angelyanga/BatLog/Study_Media/Setup_of_System.jpg

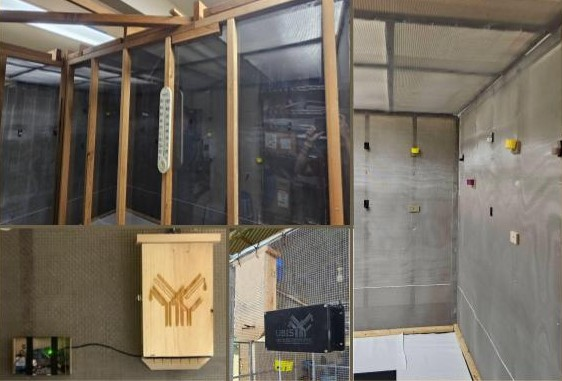
Study_Media/Setup_of_System.jpg
