angelyanga/BatLog/README.md

# BatLog
The BatLog repository stores the Instruction Manual, code, 3D-printing, and other resources for the BatLog system.
