angelyanga/BatLog/Supplemental_Materials/BatLog Bill of Materials.xlsx

Sheet: BatLog v0.2 - Teensy 4.1 Double
Subsystem | Vendor | Name | Product # | Link | Pack of | Qty Needed | Unit Cost | Notes
Main Products
Microcontroller | Amazon | Teensy 4.1 (RTC + microSD) | B088JY7P2H | https://a.co/d/0er9vC9 | 1 | 1 | *see link for updated prices
RFID Reader | Amazon | LICHIFIT 134.2K AGV RFID Module FDXB Animal Ear Tag Reader TTL FDX-B ISO11784/85 Long Distance Card Reader Module | B0B8NXKPZB | https://a.co/d/czAAwGe | 1 | 2 |  | Comes with a square antenna that was meld into a rectangle for BatLog
RFID Antenna | Amazon | 24 AWG Copper Wire | B01NBM0MB5 | https://a.co/d/cEZuwrY | 1 | 1 |  | Used for hand-coiled BatLog antennas
RTC | Amazon | DS3231 Real Time Clock Module High Precision AT24C32 IIC RTC Sensor for Arduino Nano Mega2560 Leonardo Raspberry Pi (Pack of 5) | B0CPF8X8NW | https://a.co/d/8d5YQoa | 5 | 1
RTC | Amazon | CR2032 Coin Batteries | B0CH1N7X5W | https://www.amazon.com/Energizer-2032-Batteries-Pack-Lithium/dp/B0CH1N7X5W | 10 | 1
Data Storage | Amazon | Cloudisk 2 GB microSD | B0D2SW1BLR | https://a.co/d/3SSUa5Z | 5 | 1
System Power | Pololu | 5V, 1A Step-Up/Step-Down Voltage Regulator S13V10F5 | 4083 | https://www.pololu.com/product/4083 | 1 | 1 |  | The system uses a Monolithic Power MP28167 IC (https://www.monolithicpower.com/en/documentview/productdocument/index/version/2/document_type/Datasheet/lang/en/sku/MP28167GQ/document_id/4000/)
System Power | Amazon | Micro USB Cable, 3Pack 10FT Android Charger Cable Long Nylon Braided Sync and Fast Charging Cord Compatible with Samsung Galaxy S7 S6 Edge, Android Smartphones, Tablets and More | B07GJJXQ22 | https://a.co/d/5byS6Kz | 3 | 1
LCD Screen | Amazon | 3pcs IIC I2C 2004 LCD Module 20x04 LCD Screen Module Display for Arduino Raspberry Pi | B0C1G9GBRZ | https://a.co/d/eOmFr5I | 3 | 1
System Power | Amazon | Anker Power Bank(PowerCore 10K), Compact Travel-Ready 10,000mAh Battery Pack with PowerIQ Charging Technology, 5V/3A High-Speed Charging for iPhone, iPad,and More(USB-C Input and Output(Black), 1pack) | B0D5CLSMFB | https://a.co/d/1nvrB1o | 1 | 1
Assembly | Amazon | Dupoint wire | B09FNXKXDW | https://a.co/d/bQlGRev | 120 | 1
Assembly | Amazon | 840Pcs Jumper Wire Kit Solderless Flexible Breadboard 14 Lengths Assorted Preformed Breadboard with 65Pcs Breadboard Jumper Wires, Tweezers & Plastic Box | B09NCYWK11 | https://a.co/d/iotFRED | 580 | 1
Electronics Box | Amazon | 7.87"x4.72"x2.95" Electronics Box | B08P55BZDH | https://a.co/d/0xyje59 | 1 | 1
Tools
Soldering | Amazon | Cordless Soldering Iron | B0D89TH74M | https://a.co/d/5v0dw5s | 1 | 1
Soldering | Amazon | Helping Hands | B0BHHVP467 | https://a.co/d/gkgWY17 | 1 | 1
Soldering | Amazon | Soldering Accessories | B07XZHN4W6 | https://a.co/d/3EhbDKF | 1 | 1
Antenna | Amazon | Electrical tape | B07YDRY8ZS | https://a.co/d/d8TYnZ8 | 6 | 1
Assembly | Amazon | Wire cutter & stripper (doeesn't crimp) | B073YG65N2 | https://a.co/d/azFTe3g | 1 | 1
Assembly | Amazon | Double-adhesive | B0CZL272TN | https://a.co/d/0frPdAYb | 48 | 1
Assembly | Amazon | Dupont Wire Attachments with crimper | B07QGBKFYZ | https://www.amazon.com/dp/B07QGBKFYZ?ref_=cm_sw_r_cp_ud_dp_7TNWXNMZQG7ZSE2CCAJS&newOGT=1 | 1 | 1
Data Reader | Amazon | SD Card READER | B081VHSB2V | https://a.co/d/89LaQBt | 1 | 1
Storage | Amazon | Desiccant Packs | B0CZ8Z41D3 | https://www.amazon.com/dp/B0CZ8Z41D3?ref_=cm_sw_r_cp_ud_dp_6CFE89PEH94CJM2AW8K7&newOGT=1 | 6 | 1
Testing | Amazon | Multimeter with Amp | B00KXX2OYY | https://a.co/d/0zfR9Pv | 1 | 1
Testing | Biomark | Test Tag 12mm FDX-B Key Chain | -- | https://www.biomark.com/product/pit-tag-test-key-chain/ | 1 | 1 | Contact Biomark, Inc. for Quote

Sheet: BatLog v0.2 - Arduino R4 WiFi
Subsystem | Vendor | Name | Product # | Link | Pack of | Qty Needed | Unit Cost | Notes
Main Products
Microcontroller | Amazon | Arduino R4 WiFi | B0C8V88Z9D | https://a.co/d/7gmeOOI | 1 | 1 | *see link for updated prices
RFID Reader | Amazon | LICHIFIT 134.2K AGV RFID Module FDXB Animal Ear Tag Reader TTL FDX-B ISO11784/85 Long Distance Card Reader Module | B0B8NXKPZB | https://a.co/d/czAAwGe | 1 | 1
RFID Antenna | Amazon | 24 AWG Copper Wire | B01NBM0MB5 | https://a.co/d/cEZuwrY | 1 | 1
Electronics Box | Amazon | 7.87"x4.72"x2.95" Electronics Box | B08P55BZDH | https://a.co/d/0xyje59 | 1 | 1
Data Storage | Amazon | Cloudisk 2 GB microSD | B0D2SW1BLR | https://a.co/d/3SSUa5Z | 5 | 1
Data Storage | Amazon | SD Card Module Pack, SHORT | B0989SM146 | https://a.co/d/5QhUMPs | 10 | 1
Data Reader | Amazon | SD Card READER | B081VHSB2V | https://a.co/d/89LaQBt | 1 | 1
Wire | Amazon | Dupoint wire | B09FNXKXDW | https://a.co/d/bQlGRev | 120 | 1
System Power | Amazon | Type C to USB A Cable, 10 ft, nylon braided | B07Z1FJ1J4 | https://www.amazon.com/sspa/click | 3 | 1
System Power | Amazon | Anker Power Bank(PowerCore 10K), Compact Travel-Ready 10,000mAh Battery Pack with PowerIQ Charging Technology, 5V/3A High-Speed Charging for iPhone, iPad,and More(USB-C Input and Output(Black), 1pack) | B0D5CLSMFB | https://a.co/d/1nvrB1o | 1 | 1
System Power | Amazon | Anker USA to UK Charging Brick | B0CPPGTLPC | https://www.amazon.com/dp/B0CPPGTLPC?ref=ppx_yo2ov_dt_b_fed_asin_title&th=1 | 1 | 1 |  | used for the field in Uganda
RTC Power | Amazon | CR2032 Coin Batteries | B0CH1N7X5W | https://www.amazon.com/Energizer-2032-Batteries-Pack-Lithium/dp/B0CH1N7X5W | 10 | 1
RTC Power | Amazon | Holder, CR2032 Coin Batteries | B09KTY57BJ | https://a.co/d/8rzS9Tx | 5 | 1
Tools
Soldering | Amazon | Cordless Soldering Iron | B0D89TH74M | https://a.co/d/5v0dw5s | 1 | 1
Soldering | Amazon | Helping Hands | B0BHHVP467 | https://a.co/d/gkgWY17 | 1 | 1 |  | Not required
Soldering | Amazon | Soldering Accessories | B07XZHN4W6 | https://a.co/d/3EhbDKF | 1 | 1
Antenna | Amazon | Electrical tape | B07YDRY8ZS | https://a.co/d/d8TYnZ8 | 6 | 1
Assembly | Amazon | Wire cutter & stripper (doeesn't crimp) | B073YG65N2 | https://a.co/d/azFTe3g | 1 | 1
Assembly | Amazon | Double-adhesive | B0CZL272TN | https://a.co/d/0frPdAYb | 60 | 1
Assembly | Amazon | Dupont Wire Attachments with crimper | B07QGBKFYZ | https://www.amazon.com/dp/B07QGBKFYZ?ref_=cm_sw_r_cp_ud_dp_7TNWXNMZQG7ZSE2CCAJS&newOGT=1 | 1 | 1
Testing | Amazon | Multimeter with Amp | B00KXX2OYY | https://a.co/d/0zfR9Pv | 1 | 1
Storage | Amazon | Desiccant Packs | -- | https://www.amazon.com/dp/B0CZ8Z41D3?ref_=cm_sw_r_cp_ud_dp_6CFE89PEH94CJM2AW8K7&newOGT=1 | 6 | 1 | Contact Biomark, Inc. for Quote
