angelyanga/BatLog/3D_Print_Files/6in-1.25in-Antenna-House.STL

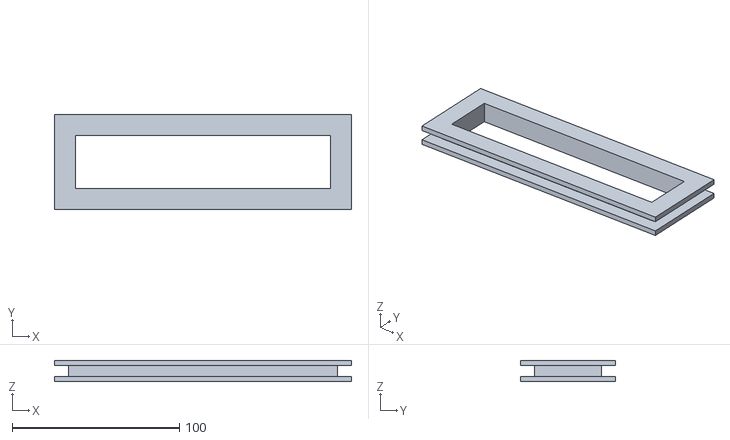
[picture p2: CAD file, 2026-04-01]
3D_Print_Files/6in-1.25in-Antenna-House.STL
177.8 x 57.1 x 12.7
