angelyanga/BatLog/(commit log)

2026-04-01 Initialize BatLog repo structure with folders
    [6in-1.25in-Antenna-House.STL, BatLog Bill of Materials.xlsx]
2026-04-02 Add BatLog v0.2 data: raw files and treatment groups
    [Epfu_Treatment_Groups.csv, Raw_BK.csv]
2026-05-26 Add 2026 PIT tag dataset from 2026 Heterothermy Study to data_used folder
    [Epfu_Treatment_Groups.csv, Raw_BK.csv]
2026-05-26 Add BatLog single and double antenna instruction manuals
2026-05-26 Remove BatLog v0.2 data folder
    [Epfu_Treatment_Groups.csv, Raw_BK.csv]
